l0cut15/onebutton-f13-esp32/_photo/shroud.jpeg

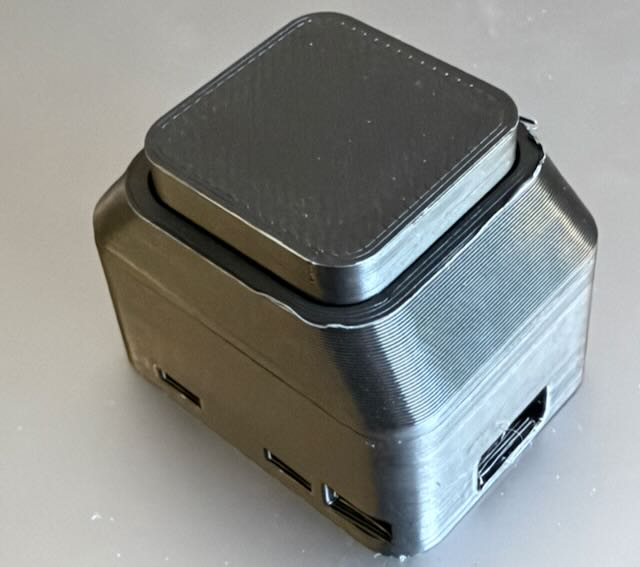
_photo/shroud.jpeg
