l0cut15/onebutton-f13-esp32/_Case/OneButton_CASE_SHELL.stl

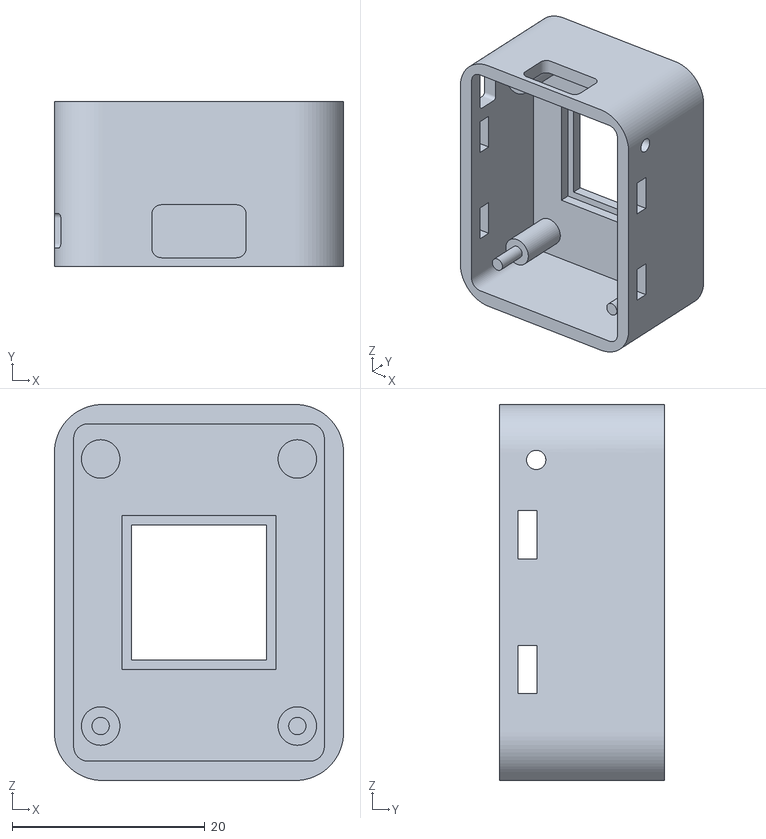
[picture p4: CAD file, 2026-10-28]
_Case/OneButton_CASE_SHELL.stl
30.0 x 17.1 x 39.0
