l0cut15/onebutton-f13-esp32/_Case/OneButton_BOTTOM_CAP.stl

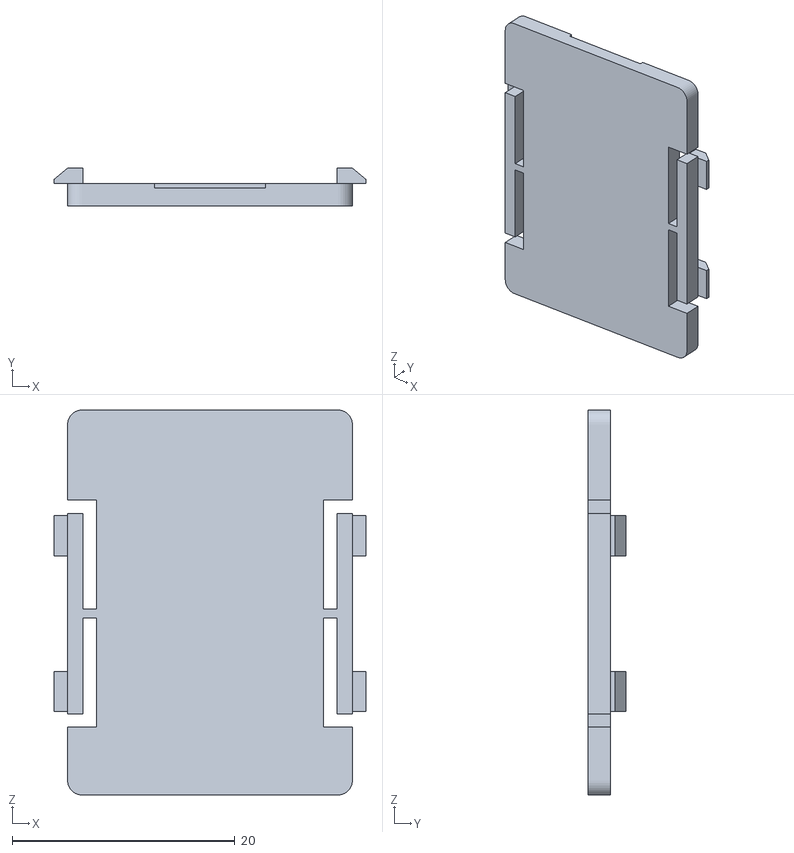
[picture p5: CAD file, 2026-10-28]
_Case/OneButton_BOTTOM_CAP.stl
28.0 x 3.40 x 34.6
