l0cut15/onebutton-f13-esp32/_Case/OneButton_SHROUD.stl

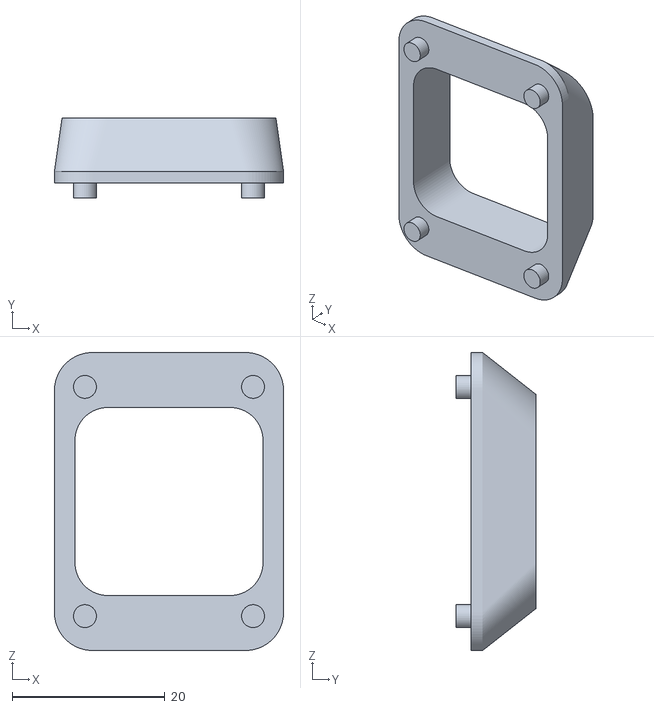
[picture p6: CAD file, 2026-10-28]
_Case/OneButton_SHROUD.stl
30.0 x 10.5 x 39.0
