l0cut15/onebutton-f13-esp32/_Case/OneButton_KEYCAP.stl

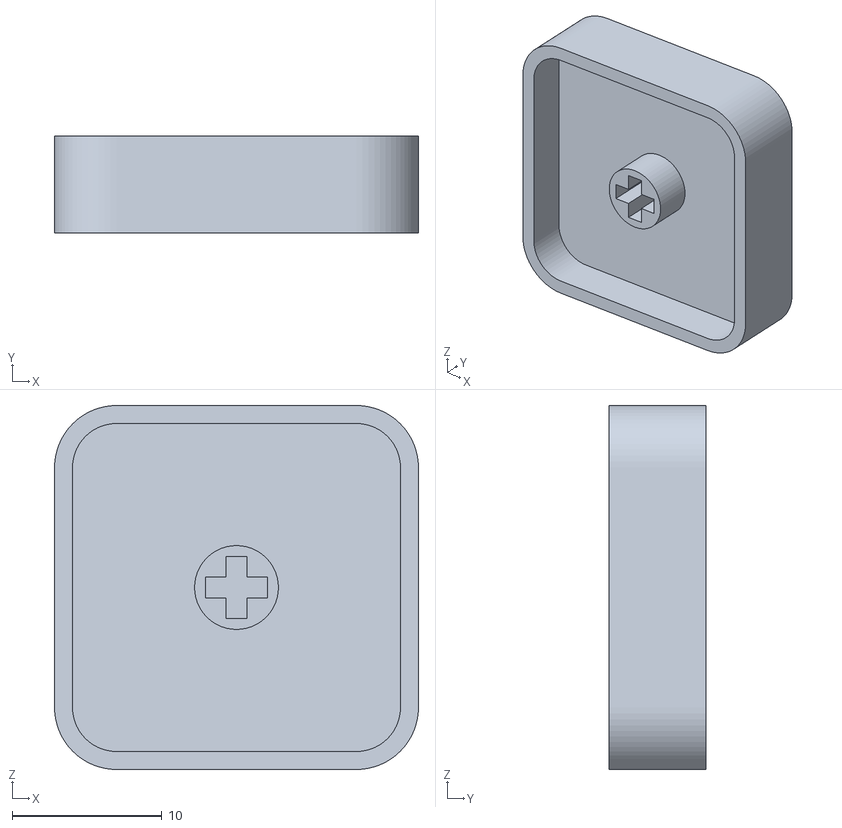
[picture p7: CAD file, 2026-10-28]
_Case/OneButton_KEYCAP.stl
24.3 x 6.50 x 24.3
