l0cut15/onebutton-f13-esp32/(commit log)

2026-10-25 One-button USB HID push-to-talk controller for ESP32-S2 mini
    ESP-IDF 5.5.4 project with esp_tinyusb pinned to 2.4.0. The device is a
    boot-keyboard HID that holds a configurable chord while the button is
    held, with debounce, ordered modifier/key reports, max-hold release,
    release on USB loss, and optional remote wakeup.
2026-10-28 Move default button GPIO from 5 to 17 (next to GND)
2026-10-28 Add 3D printed case (spec v0.11, STLs, Fusion build script) and document it in README
    [OneButton_BOTTOM_CAP.stl, OneButton_CASE_SHELL.stl, OneButton_KEYCAP.stl, OneButton_SHROUD.stl]
2026-10-28 README: rewrite as a public project page
    Drop acceptance tests and development open items, add parts list and
    assembly steps, keep the device app-agnostic.
2026-10-28 Add prebuilt firmware image and flashing instructions without ESP-IDF
    Merged image (bootloader, partition table, app) for offset 0x0, default
    settings: button GPIO17, LED GPIO15, Left Ctrl + grave.
2026-10-28 Rename to OneButton F13 and make F13 the default key
    Default chord is now F13 with no modifier, USB product string is
    "OneButton F13", and the prebuilt image is replaced by
    firmware/onebutton-f13-esp32-s2.bin built with these defaults.
    [ptt_config.h]
2026-10-28 Case v0.12 (heat-staked pegs, no cap bosses), add photos to README
    [OneButton_BOTTOM_CAP.stl, OneButton_CASE_SHELL.stl]
2026-10-28 Implement v2 config drive (SPEC_v2)
    Holding BOOT for 1 s restarts the device as a USB drive (own PID 0x4002)
    holding CONFIG.TXT and STATUS.TXT; ejecting restarts it as the keyboard
    with the new chord. The chord is read from a 1 MB FAT partition at every
    normal boot, falling back to the ptt_config.h factory default on errors
    (3 LED blinks).
    - ptt_keynames/ptt_cfgfile: key table, chord grammar, CONFIG.TXT parser,
    default and status text. No I/O, host-tested in test/ (make -C test).
    - ptt_storage: mount, format on failure, default file, STATUS.TXT only
    rewritten when changed.
    - ptt_msc: MSC-only descriptors; eject detected through esp_tinyusb's
    storage event callback, since esp_tinyusb 2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
    [partitions.csv]
2026-10-28 Record hardware test results, prepare v2.0 release
    - SPEC_v2: all section 10 acceptance tests pass on hardware; eject,
    FAT size and Keyboard Setup Assistant findings in section 12; test
    notes in section 13, including the web flasher.
    - README: firmware 2.0.0, eject is the normal exit, warn that Erase
    Flash wipes settings, upgrading from 1.x.
    - .gitattributes: leave the specs, host tests and old case history out
    of release archives.
2026-10-28 README: simplify
    Lead with why F13 is the default and that it is configurable. Add a
    Troubleshooting section (STATUS.TXT, LED patterns, UART logs). Drop the
    spec links, the upgrade notes and the How it works section, and trim
    explanations throughout.
